Reterics/Mirae/docs/hardware.md

# Hardware

## Shopping list

Buy these separately:

- Raspberry Pi 5
- Cooling for the Raspberry Pi 5: any cooler or passive case that fits within 91 × 65 × 34 mm (the space the enclosure reserves), for example the JOY-IT RB-AlucaseP5-09. The Pi stands on four 15 mm spacers (in the list below); fix it to them with 4 × M2.5 screws of the length your case needs.
- Optional: Raspberry Pi AI HAT+ 2 (40 TOPS) with its heatsink. It sits under the Pi on the tray standoffs, not on the GPIO header, so it also needs a PCIe FFC long enough for a 180° loop of about 43 mm (same contact orientation as the cable supplied with the HAT; not chosen yet) and two jumper wires for 5 V and GND.
- Adafruit VL53L1X Time-of-Flight sensor, product 3967 (the sensor mount fits its 4-hole pattern)

The rest of the parts, with supplier part numbers. Prices are net HUF as of October 2026 and will change.

| Part no. | Product | Description | Unit price | Qty | Total |
|---|---|---|---:|---:|---:|
| 100.429.00 | N20E-12-100 | Mini geared motor with encoder, 12 V DC, 100 RPM | 4 457 Ft | 2 | 8 914 Ft |
| 100.427.70 | N20-3PI-WHL | Wheel for N20 geared motor, 42 mm, 3PI miniQ | 850 Ft | 2 | 1 701 Ft |
| 100.479.92 | TB6612FNG-M | TB6612FNG dual DC motor driver module | 694 Ft | 1 | 694 Ft |
| 100.499.33 | 1000uF/16V LOW ESR 10x13 | Electrolytic capacitor, 1000 µF, 16 V, low ESR, Ø10 × 13 mm | 172 Ft | 1 | 172 Ft |
| 100.357.20 | RC-40-20/MF | Ribbon jumper cable, 20 cm, 40-pin, male–female | 928 Ft | 1 | 928 Ft |
| 100.392.82 | RPI-RIB40-C | 40-pin ribbon cable for Raspberry Pi, 20 cm, coloured | 933 Ft | 1 | 933 Ft |
| 100.374.53 | RPI-TCOBBLER | T-cobbler breakout for Raspberry Pi, breadboard | 764 Ft | 1 | 764 Ft |
| 100.431.82 | INMP441-M | Omnidirectional I2S microphone module | 1 850 Ft | 1 | 1 850 Ft |
| 100.457.04 | MAX98357-M | Class-D I2S amplifier / DAC module, max. 3 W | 925 Ft | 1 | 925 Ft |
| 100.492.93 | 3525-SPKR-4R-3W | Speaker, 4 Ω, 3 W, 35 × 25 mm | 567 Ft | 1 | 567 Ft |
| 100.510.20 | TP-INR18650-35HE | Li-ion cell, 18650, 3.6 V, 3400 mAh, 10 A | 1 055 Ft | 4 | 4 220 Ft |
| 100.418.33 | 2x18650-HOLDER | Interlocking 2-cell 18650 pack spacer / organiser | 110 Ft | 4 | 440 Ft |
| 100.468.18 | HX-2S-JH20 | BMS module, 2S, 7.4 V, 10 A, with balancing | 832 Ft | 1 | 832 Ft |
| 100.519.10 | USBC-2S-LI-BOOST | 2S Li-ion USB-C boost charger, 5 V input, 0.9 A default | 572 Ft | 1 | 572 Ft |
| 100.431.83 | SZ-08CV | DC-DC step-up/down converter, 5–30 V input, set to 5.1 V | 3 505 Ft | 1 | 3 505 Ft |
| 100.486.09 | XL6009-UD | DC-DC step-up/step-down converter, 5–30 V input, 1.4–30 V output, max. 4 A, set to 12.0 V for motors | 1 070 Ft | 1 | 1 070 Ft |
| 100.266.00 | SL 19123 | Slide switch, SPDT, 6 A / 28 V DC, main power switch on the BMS P+ load output | 573 Ft | 1 | 573 Ft |
| 100.423.96 | M3-INSERT-6 | Heat-set insert, M3 × 4.6 × 6.0 (4 join + 4 SZ-08CV standoffs) | 89,04 Ft | 8 | 712 Ft |
| 100.511.40 | M4-INSERT-6X6 | Heat-set insert, M4 × 6.0 × 6.0 (caster) | 89,24 Ft | 3 | 268 Ft |
| 100.351.72 | M 3 x 8 DBKNY | Socket head screw, M3 × 8 (joins the upper shell to the base) | 56,44 Ft | 4 | 226 Ft |
| 100.361.37 | M 3 x 6 DBKNY | Socket head screw, M3 × 6 (SZ-08CV) | 52 Ft | 4 | 208 Ft |
| 100.281.64 | M 2,5 x 6 DF | Screw, M2.5 × 6 (VL53L1X board, XL6009-UD) | 53,99 Ft | 6 | 324 Ft |
| 100.344.09 | RI M2,5x15 BB | Spacer, M2.5 female–female, hex, 15 mm (lifts the Pi over the AI HAT+ 2 space) | 128 Ft | 4 | 512 Ft |
| 100.284.06 | M 2,5 x 10 DF | Screw, M2.5 × 10 (from under the tray, through the standoffs and the HAT into the spacers) | 52,35 Ft | 4 | 209 Ft |
| 100.309.73 | M 2 x 6 DF | Screw, M2 × 6, stainless (camera) | 48,93 Ft | 4 | 196 Ft |
| 100.418.35 | NICKEL-STRIP | Nickel-plated steel strip, 100 × 7 × 0.1 mm, for spot-welding the pack | 72,49 Ft | 4 | 290 Ft |
| 100.414.62 | VELCRO-BK | Hook-and-loop strap, 20 × 300 mm (holds the battery pack) | 480 Ft | 2 | 960 Ft |
| 100.233.77 | CV 100/2,5/B | Cable ties, 2.5 × 100 mm, pack of 100 (motors) | 292 Ft | 1 | 292 Ft |
| 100.488.80 | RPI-CM3-NOIR | Raspberry Pi Camera Module 3 NoIR, Sony IMX708, 12 MP | — | 1 | — |
| | | | | **Total** | **32 857 Ft** |

For each part's real dimensions and how they compare with the enclosure, see [parts.md](parts.md).

Also needed, not from HESTORE: the front caster, a [GG-KUB-30-B](https://kerekaruhaz.hu/spd/308640/GG-KUB-30-B-peremes-sullyesztheto-rogzito-furatos) flanged ball transfer unit (Ø30 steel ball, 75 kg; kerekaruhaz.hu, 2 377 Ft net / 3 019 Ft gross), and 3 × M4 screws for it, length **TBD** until the flange's sheet thickness is measured (they pass through the flange and the 1.7 mm spacer into the 6 mm inserts). Also 4 × Ø5 × 2 mm N38 neodymium magnets for the lid (two pairs; [orodian.hu V5-2-N38](https://orodian.hu/termek/neodimium-hengermagnes-5x2-mm-n38), 50 Ft each incl. VAT), and a spot welder to build the pack. For the Pi: 4 × M2.5 screws from the case into the spacers, of the length your cooler or case needs.

The total doesn't include the Raspberry Pi 5, its cooling case, the optional AI HAT+ 2, the VL53L1X, the caster and its screws, or the magnets. The HESTORE cart export matches the products and quantities above:
[hestore_20261022.xml](hestore_20261022.xml)

## Components by subsystem

| Subsystem | Component | Notes |
|---|---|---|
| Compute | Raspberry Pi 5 | With a cooler or passive case within 91 × 65 × 34 mm, on 15 mm spacers |
| Compute (optional) | Raspberry Pi AI HAT+ 2, 40 TOPS | Under the Pi, linked by the PCIe FFC; the space is always reserved |
| Drive | 2× N20 12 V 100 RPM geared motors with encoders | Differential drive |
| Drive | 2× 42 mm wheels, 1× GG-KUB-30-B ball transfer unit (Ø30 ball) | |
| Drive | TB6612FNG dual motor driver, 1000 µF low-ESR capacitor | |
| Distance | VL53L1X Time-of-Flight sensor | Short-range obstacle detection |
| Vision | Raspberry Pi Camera Module 3 NoIR | Sony IMX708, 12 MP, no IR filter |
| Audio in | INMP441 I2S MEMS microphone | |
| Audio out | MAX98357 I2S DAC / Class-D amplifier, 4 Ω / 3 W speaker | |
| Power | 4× 18650 Li-ion (2S2P), 2S BMS, SZ-08CV at 5.1 V, XL6009-UD at 12.0 V | Separate Pi/logic and motor rails |
| Charging | USBC-2S-LI-BOOST 2S USB-C charger | 5 V USB-C input, 0.9 A default charge current |
| Wiring | 40-pin ribbon cables, T-cobbler | Prototyping |

## Main computer

The Raspberry Pi 5 handles camera processing, speech recognition, text-to-speech, behavior logic, sensor processing, motor control, communication with AI services and the local web/API interface.

## Drive system

The first version uses a differential-drive layout:

```text
            FRONT
       ┌───────────────┐
       │    CAMERA     │
       └───────────────┘
             ○
         BALL CASTER

        O             O
     LEFT           RIGHT
     MOTOR          MOTOR
            REAR
```

The wheels sit 30 mm behind the centre of the 210 mm body and the caster far forward: a 97 mm wheelbase and a 139 mm track. The caster carries about 37% of the weight (see the [mass budget](parts.md#mass-budget)).

Encoders enable speed control, distance estimation, PID control, straighter driving and basic odometry.

## Sensors

- **Camera Module 3 NoIR** — object and person detection, person tracking, visual navigation, future VLM experiments.
- **VL53L1X ToF** — short-range obstacle detection and collision avoidance. Future versions may use multiple ToF sensors or LiDAR.

## Audio

- **INMP441** — voice recording, wake-word detection, speech recognition, environmental audio.
- **MAX98357 + 4 Ω / 3 W speaker** — text-to-speech, sound effects, status feedback.

## Enclosure

A small, minimal cube-like body, roughly 120–150 mm wide, designed as modular parts rather than a single shell so individual components can change without redesigning the whole robot:

```text
┌─────────────────────┐
│      TOP COVER      │
├─────────────────────┤
│     PI 5 MODULE     │
├─────────┬───────────┤
│ MOTOR   │   MOTOR   │
│ MOUNT   │   MOUNT   │
└─────────┴───────────┘
```

It provides mounting points for the Pi 5 and its cooling case, camera, microphone, speaker, motor driver, both motors, wheels, ball caster, VL53L1X, wiring and the 2S2P battery/power system.

See [`cad/README.md`](../cad/README.md) for printable STLs, print settings and enclosure assembly instructions.
