Reterics/Mirae/assets/CREDITS.md

# Production media credits

Product renders use the following Poly Haven assets, distributed under CC0
(public domain). Authoring inputs are maintained privately.

| Asset | Used for | Source |
|---|---|---|
| Photo Studio Loft Hall | Interior lighting and reflections | https://polyhaven.com/a/photo_studio_loft_hall |
| Laminate Floor 02 | Wood floor | https://polyhaven.com/a/laminate_floor_02 |
| Modern Arm Chair 01 | Furniture | https://polyhaven.com/a/modern_arm_chair_01 |
| Mid Century Lounge Chair | Furniture | https://polyhaven.com/a/mid_century_lounge_chair |
| Modern Coffee Table 01 | Furniture and scale reference | https://polyhaven.com/a/modern_coffee_table_01 |
| Book Encyclopedia Set 01 | Table props | https://polyhaven.com/a/book_encyclopedia_set_01 |
| Potted Plant 02 | Plant | https://polyhaven.com/a/potted_plant_02 |

The Raspberry Pi 5 model is by Raspberry Pi Ltd, under the MIT licence
(Copyright (c) 2026 Raspberry Pi Ltd), from
https://pip.raspberrypi.com/categories/892-raspberry-pi-5.
Product renders use the original model. The assembly guide embeds a simplified
copy and board colour atlas in `site/public/media/assembly/assembly.glb`.
The full licence is preserved in
[`LICENSE-raspberry-pi-5-model.txt`](../site/public/media/assembly/LICENSE-raspberry-pi-5-model.txt).

The family illustration and the printing and floor footage are AI-generated.

The administration console bundles IBM Plex Sans Regular, Medium and SemiBold
from [IBM Plex](https://github.com/IBM/plex). Its Open Font License is preserved
in [`src/mirae/admin/fonts/LICENSE.txt`](../src/mirae/admin/fonts/LICENSE.txt).
