Reterics/Mirae/docs/roadmap.md

# Roadmap

### V0.1 — Movement

- [ ] Raspberry Pi GPIO setup
- [ ] TB6612FNG driver
- [ ] Motor control
- [ ] Forward/backward movement
- [ ] Rotation
- [ ] Basic REST API

### V0.2 — Sensors

- [ ] VL53L1X integration
- [ ] Obstacle detection
- [ ] Emergency stop behavior
- [ ] Encoder support
- [ ] Basic odometry

### V0.3 — Vision

- [ ] Camera Module 3 support
- [ ] Camera streaming
- [ ] Person detection
- [ ] Object detection
- [ ] Person tracking

### V0.4 — Voice

- [ ] INMP441 microphone
- [ ] MAX98357 audio output
- [ ] Whisper speech recognition
- [ ] Text-to-speech
- [ ] Basic voice commands

### V0.5 — AI

- [ ] LLM API abstraction
- [ ] Ollama support
- [ ] Structured AI actions
- [ ] Behavior engine
- [ ] Conversational interaction

### V0.6 — Autonomous behavior

- [ ] Exploration
- [ ] Person following
- [ ] Idle behaviors
- [ ] Personality states
- [ ] Environment awareness

### V1.0 — Complete robot

- [ ] Final Blender enclosure
- [ ] Printable STL files
- [ ] Internal cable management
- [ ] Battery power
- [ ] Autonomous startup
- [ ] Documentation
- [ ] Reproducible build

## Long-term ideas

Raspberry Pi AI HAT, accelerated local Whisper, local VLM, IMU, LiDAR, multiple ToF sensors, charging dock with automatic docking, wake-word detection, OLED/LED face and emotion animations, ROS 2, SLAM and room mapping, object search, gesture recognition, autonomous exploration.
