Reterics/Mirae/(list of files, cad)

Other CAD files:
cad/stl/caster-spacer.stl
cad/stl/chassis.stl
cad/stl/sensor-mount.stl
cad/stl/top-cover.stl
cad/stl/pi-module.stl
cad/stl/faceplate.stl
