Reterics/Mirae/src/mirae/pipeline/devices.py

"""Enumerate real OS camera and microphone devices, and open microphones safely."""

from __future__ import annotations

import platform
import threading
import time
from collections.abc import Callable, Iterator
from contextlib import contextmanager
from typing import Any

# PortAudio reads the device list once, when sounddevice is imported. A device that restarts or
# reconnects later (a wireless headset, a virtual mic such as SteelSeries Sonar) then fails to open
# from this long-running process with "Unanticipated host error ... [MME error 1]", while a fresh
# process opens it fine. Re-scanning (terminate + initialize) fixes that, but it also closes every
# open stream, so it only runs while none of ours are open.
_audio_lock = threading.Lock()
_open_inputs = 0


def _rescan_audio() -> None:
    """Re-read PortAudio's device list. Call with ``_audio_lock`` held and no stream open."""
    import sounddevice as sd

    sd._terminate()
    sd._initialize()


def _input_id(device: dict[str, Any], hosts: Any) -> str:
    """Stable microphone identity. List indexes shift when devices come and go; names don't."""
    return f"{hosts[device['hostapi']]['name']}:{device['name']}"


def _resolve_input(device_id: str | None) -> int | None:
    """PortAudio index for a saved microphone identity. None means the system default."""
    import sounddevice as sd

    if device_id is None:
        return None
    hosts = sd.query_hostapis()
    for index, device in enumerate(sd.query_devices()):
        if device["max_input_channels"] > 0 and _input_id(device, hosts) == device_id:
            return index
    raise RuntimeError(
        f"Selected microphone ({device_id}) is no longer connected. Refresh the device list."
    )


@contextmanager
def open_input(
    device_id: str | None,
    *,
    callback: Callable[..., None] | None = None,
    block_s: float = 0.25,
) -> Iterator[tuple[Any, dict[str, Any], int]]:
    """Open a mono int16 microphone stream at 16 kHz, or the device's own rate if it refuses.

    Yields ``(stream, device_info, sample_rate)``. The stream is started and is closed on exit.
    """
    import sounddevice as sd

    global _open_inputs
    with _audio_lock:
        if _open_inputs == 0:
            _rescan_audio()
        device = _resolve_input(device_id)
        info = sd.query_devices(device, "input")
        rate = 16000
        try:
            sd.check_input_settings(device=device, channels=1, samplerate=rate, dtype="int16")
        except sd.PortAudioError:
            rate = int(info["default_samplerate"])
        stream = sd.RawInputStream(
            samplerate=rate,
            channels=1,
            dtype="int16",
            device=device,
            blocksize=round(rate * block_s),
            callback=callback,
        )
        _open_inputs += 1
    try:
        with stream:
            yield stream, info, rate
    finally:
        with _audio_lock:
            _open_inputs -= 1


def _resolve_output(device_id: str | None) -> int | None:
    """PortAudio index for a saved speaker identity. None means the system default."""
    import sounddevice as sd

    if device_id is None:
        return None
    hosts = sd.query_hostapis()
    for index, device in enumerate(sd.query_devices()):
        if device["max_output_channels"] > 0 and _input_id(device, hosts) == device_id:
            return index
    raise RuntimeError(
        f"Selected speaker ({device_id}) is no longer connected. Refresh the device list."
    )


def play_pcm(
    pcm: bytes, sample_rate: int, device_id: str | None, stop: threading.Event
) -> dict[str, Any]:
    """Play mono int16 PCM, blocking until done or ``stop`` is set. Returns the device info."""
    import sounddevice as sd

    global _open_inputs
    with _audio_lock:
        if _open_inputs == 0:
            _rescan_audio()
        device = _resolve_output(device_id)
        info = sd.query_devices(device, "output")
        stream = sd.RawOutputStream(
            samplerate=sample_rate, channels=1, dtype="int16", device=device
        )
        # Counted with the microphones so a rescan never closes a playing stream.
        _open_inputs += 1
    try:
        with stream:
            block = sample_rate // 5 * 2
            for start in range(0, len(pcm), block):
                if stop.is_set():
                    break
                stream.write(pcm[start : start + block])
    finally:
        with _audio_lock:
            _open_inputs -= 1
    return dict(info)


def camera_devices() -> dict[str, Any]:
    try:
        import cv2
        from cv2_enumerate_cameras import enumerate_cameras

        backend = {
            "Windows": cv2.CAP_DSHOW,
            "Darwin": cv2.CAP_AVFOUNDATION,
        }.get(platform.system(), cv2.CAP_ANY)
        cameras: list[dict[str, Any]] = [
            {
                "id": f"opencv:{c.backend}:{c.path or c.name}",
                "name": c.name,
                "index": c.index,
                "backend": c.backend,
                "path": c.path,
                "source": "opencv",
            }
            for c in enumerate_cameras(backend)
        ]
        # Prefer a physical device to a virtual camera for automatic selection.
        cameras.sort(key=lambda c: ("virtual" in c["name"].lower(), c["index"]))
        try:
            from picamera2 import Picamera2

            for item in Picamera2.global_camera_info():
                cameras.append(
                    {
                        "id": f"picamera2:0:{item['Num']}",
                        "name": item["Model"],
                        "index": item["Num"],
                        "backend": 0,
                        "path": item.get("Id", ""),
                        "source": "picamera2",
                    }
                )
        except ImportError:
            pass
        return {"items": cameras, "error": None, "checked_at": time.time()}
    except Exception as exc:
        return {"items": [], "error": f"{type(exc).__name__}: {exc}", "checked_at": time.time()}


def audio_devices() -> dict[str, Any]:
    try:
        import sounddevice as sd

        with _audio_lock:
            if _open_inputs == 0:
                _rescan_audio()
            devices = sd.query_devices()
            hosts = sd.query_hostapis()
            # Output-only machines and unplugged default microphones still have
            # useful devices. Failure to resolve a default must not hide them.
            try:
                default = int(sd.query_devices(kind="input")["index"])
            except sd.PortAudioError:
                default = None
        inputs = [
            {
                "id": _input_id(d, hosts),
                "index": i,
                "name": d["name"],
                "host_api": hosts[d["hostapi"]]["name"],
                "channels": int(d["max_input_channels"]),
                "sample_rate": int(d["default_samplerate"]),
                "default": i == default,
            }
            for i, d in enumerate(devices)
            if d["max_input_channels"] > 0
        ]
        inputs.sort(key=lambda d: (not d["default"], d["index"]))
        outputs = [
            {"id": _input_id(d, hosts), "name": d["name"], "host_api": hosts[d["hostapi"]]["name"]}
            for d in devices
            if d.get("max_output_channels", 0) > 0
        ]
        return {
            "items": inputs,
            "outputs": outputs,
            "default": default,
            "error": None,
            "checked_at": time.time(),
        }
    except Exception as exc:
        return {
            "items": [],
            "outputs": [],
            "default": None,
            "error": f"{type(exc).__name__}: {exc}",
            "checked_at": time.time(),
        }
