Reterics/Mirae/(commit log)

2026-10-22 chore: initial design and implementation
    [battery-door.stl, chassis.stl, faceplate.stl, pi-module.stl, robot.blend, sensor-mount.stl, top-cover.stl]
2026-10-23 chore: update render and parts
    [battery-door.stl, chassis.stl, pi-module.stl, robot.blend, sensor-mount.stl, top-cover.stl]
2026-10-24 chore: update ball caser and battery position
    [caster-spacer.stl, chassis.stl]
2026-10-24 chore: fine tune landing page
